Malk10/MLK_RGB_CONTROLLER/(list of files, drawings)

Other design files:
RGB Controller FINAL/PROTEUS/MLK RGB Controller.pdsprj
